tkahrs702-dotcom/hidden-device-hunter/firmware/phase3-p4-rfcam/README.md

# Phase 3 firmware: not written

This folder is a placeholder. See [`../../docs/manual/03-phase3-p4-rf-camera.md`](../../docs/manual/03-phase3-p4-rf-camera.md).
