tkahrs702-dotcom/hidden-device-hunter/docs/parts.md

# Parts and shopping

Prices checked online on **2026-10-03**; they move, so treat them as a guide. "Have" = Taelor already owns it.
The same list as a spreadsheet: [`parts.csv`](parts.csv).

## Totals

| Phase | New parts cost (USD) | Notes |
|---|---|---|
| 1 | about **$7–14**, plus $10–20 if you need a power bank | Uses the Uno R4 you have |
| 2 | about **$24–35** | Adds to Phase 1; nothing from Phase 1 is thrown away |
| 3 | don't buy yet | No firmware exists for Phase 3 (see `phase3.md`) |

## Phase 1 — buzzer finder

| Part | Qty | Pick | Where to buy (price) |
|---|---|---|---|
| Arduino Uno R4 WiFi | 1 | — | Have |
| Passive piezo buzzer | 1 | A **passive** 2-pin piezo (needs a signal to make sound), or a 3-pin passive buzzer module. Not "active". | [Keyestudio passive module ($3.80)](https://www.keyestudio.com/products/free-shipping-keyestudio-passive-buzzer-alarm-module-for-arduino) · [Aretronics passive module ($1.00)](https://aretronics.com/products/passive-buzzer-module) · any electronics store, 10-packs of 2-pin passive piezos run about $8–10 |
| 100 Ω resistor, 1/4 W | 1 | Brown-black-brown | Any resistor kit; skip it if you use a 3-pin module |
| Mini breadboard + jumper wires | 1 + 4 | 170- or 400-point breadboard, male-male jumpers | Any store; about $5–10 for both |
| USB-C cable | 1 | Must be a **data** cable (charge-only cables won't upload) | Have, most likely |
| USB power bank | 1 | Any 5V bank. Get a **2-port** one: Phase 2 needs both
