tkahrs702-dotcom/hidden-device-hunter/docs/worklog/2026-10-05-hal-setup.md

# 2026-10-05 HaL setup check
Asked from the Claude app Project: set up HaL for this project per `docs/computers.md` and run `tools/setup.sh`. Run on HaL (user `user1`).

- Checked out `claude/build-manual-schematics-4gaef6` (PR #2). `tools/setup.sh --check`: repo location ok, git up to date, then
  stopped: `arduino-cli not installed`. `~/.arduino15` does not exist, so no cores either.
- `user1` is not in `dialout` (groups: adm cdrom sudo dip plugdev users lpadmin sambashare kvm). Fix needs sudo:
  `sudo usermod -aG dialout user1`, then log out and back in.
- No serial boards plugged into HaL (no `/dev/ttyACM*`, `/dev/ttyUSB*`, `/dev/serial/by-id/`).
- Doc fix in `docs/computers.md`: the HaL column said "run `tools/setup.sh` once", but the script does not install arduino-cli.
  Added the no-sudo install command (pinned 1.3.1, into `~/.local/bin`) and a note on the esp32 core download size.
- Nothing installed, nothing flashed. Waiting on Taelor's yes for the arduino-cli install and core downloads.
- Taelor asked for HaL and HaLjr to be told what each still needs to do. HaLjr was unreachable from HaL (`haljr.local` did not resolve,
  no SSH answer on the LAN), so the per-computer to-do list went into `HANDOFF.md` (section "Computers") and a brief in
  claude-hub `readmes/briefs/`, which `claude-sync` shares to every computer.
- Taelor said yes. Installed arduino-cli 1.3.1 into `~/.local/bin`. First `tools/setup.sh` run failed downloading the ARM toolchain
  (`context deadline exceeded` at ~200 KB/s); after `arduino-cli config set network.connection_timeout 1800s` the rerun installed
  arduino:renesas_uno 1.6.0 and esp32:esp32 3.3.12, and compiled phase1-r4-finder, phase2-r4-display and phase2-xiao-sniffer (all ok).
  Remaining WARN: `user1` not in `dialout`. `arduino-cli board list`: no boards found. Added the timeout tip to `docs/computers.md`.
- Taelor ran `sudo usermod -aG dialout user1`; `/etc/group` confirms it. Login sessions started before that still lack the group, and
  `setup.sh` used to call that "not in dialout". It now checks the account too and says when only a log-out/log-in is pending.
