tkahrs702-dotcom/hidden-device-hunter/docs/worklog/2026-10-03-manual.md

# 2026-10-03: full manual written
- Taelor asked why the README was thin; the project held only the copied Android-app docs. Wrote `docs/manual/` (00-05): per-phase parts, pin-to-pin wiring, ASCII diagrams, assembly, software, test sketches, troubleshooting, verification log.
- Verified against sources: P4 40-pin header table (Waveshare), XIAO pin map (Seeed), R4 D0/D1/5 V logic/8 mA limit (Arduino docs). Not verified: R4 tone() on D8, P4 battery polarity, P4 5V on LiPo, Adafruit 757/BNO085 details (from the original guide).
- Firmware still not written. README rewritten as an index.
- Later same day: closed all open verification items. tone() works on any pin (core source); 757 silkscreen read from Adafruit board file; BNO085 alternate address 0x4B is via DI high, not ADR (manual corrected); P4 battery J2 pin1=BAT and header 5V = VCC_5V rail with battery boost, read from Waveshare schematic. Only two bench multimeter checks remain.
