tkahrs702-dotcom/hidden-device-hunter/docs/manual/05-reference.md

# 05. Pin reference, wire index and diagrams

## Diagram index (`docs/manual/diagrams/`)
| File | Shows |
|---|---|
| [`system-overview.svg`](diagrams/system-overview.svg) | every board, which phase adds it, the links between them and their voltage |
| [`phase1-wiring.svg`](diagrams/phase1-wiring.svg) / [`phase1-schematic.svg`](diagrams/phase1-schematic.svg) | R4 + resistor + buzzer |
| [`level-shifter.svg`](diagrams/level-shifter.svg) | generic vs Adafruit 757 pin names, one channel's circuit, channel use per phase |
| [`phase2-wiring.svg`](diagrams/phase2-wiring.svg) / [`phase2-schematic.svg`](diagrams/phase2-schematic.svg) | Historical XIAO-S3 layout; do not use for current Phase 2 wiring |
| [`phase2-xiao-c5-wiring.svg`](phase2-xiao-c5-wiring.svg) / [`phase2-xiao-c5-schematic.svg`](phase2-xiao-c5-schematic.svg) | Updated Seeed XIAO ESP32-C5 wiring, UART pin mapping and separate USB power |
| [`phase3-wiring.svg`](diagrams/phase3-wiring.svg) / [`phase3-schematic.svg`](diagrams/phase3-schematic.svg) | P4 + XIAO + BNO085 + camera + LiPo, optional R4 link |
The SVGs are generated by [`tools/diagrams/make_diagrams.py`](../../tools/diagrams/make_diagrams.py) (Python 3, no dependencies):
```
python3 tools/diagrams/make_diagrams.py          # rewrite all SVGs
tools/diagrams/render.sh /tmp/hdh-render         # optional: PNG previews (needs Chromium headless_shell)
```
Change a pin in the script, the phase file's wire list and the firmware together, never one alone.

## Wire colours (same in every diagram)
| Colour | Meaning |
|---|---|
| red | 5 V power or reference |
| orange | 3.3 V power or reference |
| black | ground |
| magenta | LiPo + |
| purple | Archived Phase 1 buzzer signal; do not use for V2 |
| yellow | R4 TX -> XIAO RX (Phase 2); parked Phase 3 I2C SCL |
| green | XIAO TX -> R4 or P4 RX |
| cyan | P4 TX -> XIAO RX |
| brown | P4 TX -> R4 RX (optional) |
| blue | I2C SDA |
| grey | coax / USB cable |
Dashed = optional. Real jumper colours do not matter; the IDs do.

## V2 Phase 2 wires, by ID
| ID | Phase | From | To | Jumper |
|---|---|---|---|---|
| P1 | 2 | R4 5V | shifter HV only | - |
| P2 | 2 | XIAO 3V3 | shifter LV | - |
| P3 | 2 | R4 GND | shifter high-side GND | - |
| P4 | 2 | XIAO GND | shifter low-side GND | - |
| S1 | 2 | R4 D1 (TX) | shifter B1/A1 | - |
| S2 | 2 | shifter A1/B1 | XIAO D7 (RX, GPIO12) | - |
| S3 | 2 | XIAO D6 (TX, GPIO11) | shifter A2/B2 | - |
| S4 | 2 | shifter B2/A2 | R4 D0 (RX) | - |
| A1 | 2 | XIAO C5 RF connector | Rokland antenna cable (check connector when delivered) | - |
R4 and XIAO are powered separately over USB-C for Phase 2 bench tests; their 5 V rails are not connected.
Phase 1 uses the Qwiic Modulino Buzzer and requires no jumper-wire table. The older D8 passive-buzzer wiring is archived in `01-phase1-finder.md`; it is not current V2 hardware. Phase 3 connections below are preserved design notes only and are not V2 build instructions.

## Signals between boards
| Link | Signal | Level | Direction | Wires |
|---|---|---|---|---|
| XIAO -> R4 (Phase 2) | UART 115200 8N1 | 3.3 V XIAO / 5 V R4 via shifter | XIAO -> R4; reverse direction reserved | XIAO D6/GPIO11 -> A2/B2 -> R4 D0; R4 D1 -> B1/A1 -> XIAO D7/GPIO12 reserved; common GND |
| XIAO <-> P4 (Phase 3) | UART 115200 8N1 | 3.3 V | both | T3 (XIAO D6 -> P4 pin 11 GPIO5); T4 (P4 pin 14 GPIO4 -> XIAO D7); ground T2 |
| P4 -> R4 (optional) | UART | 3.3 V to 5 V via shifter ch 3 | one way | O1, O4 (P4 pin 8 GPIO2 -> LV3/HV3 -> R4 D0) |
| BNO085 <-> P4 | I2C 0x4A | 3.3 V | both | I2 SDA pin 4, I3 SCL pin 6 |
| R4 -> buzzer | tone, about 2.5 kHz | 5 V | out | W1 D8 via R1 100 ohm |

XIAO -> R4 line protocol (`phase2-xiao-sniffer` -> `phase2-r4-display`), one ASCII line each, `\n` terminated:
| Line | Meaning | Rate |
|---|---|---|
| `L,<MAC>,<cat>,<maker>` | locked onto MAC; cat 0 unknown, 1 camera maker, 2 IoT chip | on lock |
| `U` | unlocked | on unlock and at boot without a saved lock |
| `T,<now>,<avg>,<ch>,<pps>,<idle pps>,<wobble dB>,<wave 0/1>` | target RSSI now and averaged (dBm), channel, packets/s, idle packets/s, wobble (dB spread), hand-wave spike flag | up to 10 per second while heard |
| `S,<total>,<cams>,<iot>,<hidden>,<locked>` | devices heard in the last 60 s | once a second |

## Power
| Board | Powered from | Notes |
|---|---|---|
| R4 | USB-C (computer or power bank) | 5 V pin ~4.7 V on USB; max 8 mA per I/O pin, 60 mA total |
| XIAO (Phase 2 bench) | its own USB-C | Separate from R4 USB-C; do not connect the 5 V rails |
| XIAO (Phase 3) | P4 header pin 1 (5V) via T1 | never also plug its USB-C; Seeed's "5V dead on battery" refers to the XIAO's own battery pads, not this feed; P4 header 5V comes from its boost on LiPo |
| Shifter | HV from R4 5V, LV from XIAO 3V3 (Phase 2) or P4 pin 18 (Phase 3) | both sides must be powered for data to pass |
| BNO085 | P4 pin 2 (3V3) | |
| P4 | USB-C or MX1.25 LiPo | short-press POWER |

## Board pin cheats
- **R4 (USB-C on the left):** top header SCL SDA AREF GND 13 12 11 10 9 8 | 7 6 5 4 3 2 TX>1 RX<0. Bottom header (blank) IOREF RESET 3.3V 5V GND GND VIN | A0-A5.
  D0 = RX, D1 = TX (`Serial1`). Debug on USB `Serial`. 12x8 LED matrix on board.
- **Seeed XIAO ESP32-C5:** D6=GPIO11/TX, D7=GPIO12/RX, BOOT=GPIO28.
- **XIAO ESP32-S3 (legacy pin reference only):** left column D0-D6, right column 5V, GND, 3V3, D10, D9, D8, D7.
  D0=GPIO1, D1=2, D2=3, D3=4, D4=5 (SDA), D5=6 (SCL), D6=43 (TX), D7=44 (RX), D8=7, D9=8, D10=9. BOOT button = GPIO0.
- **Shifter:** see [`level-shifter.svg`](diagrams/level-shifter.svg) and 02 section 2.2.
- **P4 header:** see the full table in [`03-phase3-p4-rf-camera.md`](03-phase3-p4-rf-camera.md).

## Verification status
All items from the original guide are checked against sources (see the log in `00-overview-and-safety.md`).
Two bench confirmations remain, both one-minute multimeter checks done when you have the hardware:
1. Header 5V (pin 1 or 3) reads about 5 V when the P4 runs on LiPo alone (the schematic says yes).
2. LiPo plug: red wire lands on J2 pin 1 (BAT) and black on pin 2 (GND) before you connect it.
Diagrams are drawn from the same sources; physical part positions (R4 matrix, XIAO u.FL socket, P4 connectors) are approximate, pin
order is exact. Generic shifter clones vary in pin order: wire by the printed label.
