tkahrs702-dotcom/hidden-device-hunter/docs/worklog/2026-10-26-c5-firmware-review.md

# 2026-10-26: C5 sniffer and R4 display review

- Reviewed `phase2-xiao-sniffer` and `phase2-r4-display`. Pins (D6=GPIO11, D7=GPIO12, BOOT=GPIO28) are not the C5's USB pins (GPIO13/14), so the firmware cannot switch USB off. The default Tuya lock (10:5A:17:6C:02:4D, ver 1) is applied on the first boot; the R4's X confirms it was.
- Fixed: a locked target that went quiet for 4 s sent the C5 back to sweeping all 36 channels (8+ s per pass), so a plug that talks every few seconds was almost never caught and the R4 sat on X. The C5 now waits on the target's last channel for 30 s before sweeping.
- Fixed: USB text could stall the loop up to 100 ms per line when a computer was attached but nothing read the port; it is now dropped instead.
- Flash failures ("Failed to start stub flasher", "No serial data received") come from the USB reset into download mode, not the sketch. Hold BOOT while plugging the C5 in, then upload.
- Not run on hardware in this session; CI compiles it.
- PRs #9 and #10 merged. Added a peak marker on the R4: a dot on the top row over the best bar reached since the lock, so the closest approach can be read after walking away. Resets on a new lock.
- Phone dashboard (JS syntax-checked, C++ compiled by CI only, not run on hardware): the R4 makes Wi-Fi "HDH-Finder" and serves http://192.168.4.1 with the monitored target, live dBm, closest approach, graph, warmer/colder recommendation, sniffer counts and the 6 nearby suspects, plus an "All devices" list of up to 60 with maker and network name (`webview.h`; the C5 now sends B/D lines every 2 s).
- Hidden networks: the phone lists now rank camera makers, IoT chips, then hidden networks (labelled "hidden net") before everything else, in the same order as the C5's BOOT button, and a BOOT column says how many presses lock each suspect. Hold BOOT 1 s resets the count. Hidden devices that only probe use random MACs and cannot be locked by MAC.
- 2026-10-27: phone dashboard moved to Bluetooth LE on the C5 (decision: C5 Bluetooth, Android). The C5 streams the same lines it sends the R4 (plus a 40-device list with packets, last-heard and flags) to a connected phone and accepts `K,<MAC>` (track), `U` (unlock) and `V,<0-3>` (buzzer volume, forwarded to the R4 over the existing one-way wire). The page is `tools/finder/finder.html` (Web Bluetooth, Chrome on Android). The page was tested in demo mode in a headless browser; the Bluetooth link itself is untested on hardware.

## 2026-10-27
Added the C5 Bluetooth LE scan and a Wi-Fi / Bluetooth / both switch (default Wi-Fi only), a mode switch on `tools/finder/finder.html`, and a handoff doc. Hardware tests were frustrating (flash timing, R4 Wi-Fi flaky, Brave blocks Web Bluetooth, private repo links). Taelor asked for a note that the approach needs rethinking for ease of use: `docs/v2/NOTE-ease-of-use-redesign.md`.
