tkahrs702-dotcom/hidden-device-hunter/docs/worklog/2026-10-17-modulino-buzzer-status.md

# 2026-10-17: Modulino buzzer flashed (status note)
Status recorded in the Photo to Sold Claude project (thread "Flash R4 network finder") and first sent to the sentinel session by mistake; filed here where it belongs.
- Hardware: Arduino UNO R4 WiFi with a Modulino Buzzer on the Qwiic socket, plugged into HaLjr (not HaL).
- Phase 1: `firmware/phase1-r4-finder/phase1-r4-finder.ino`. The Modulino version was written on HaLjr around 9:17 that morning and not committed. Flashed 17:16 UTC: boot printed "Buzzer found", the beep test worked, and the scan listed CenturyLink8864 at about -65 dBm. Pushed to branch `modulino-buzzer` (not merged to main).
- Phase 2 Modulino sketch compiles but is not flashed; it needs the XIAO wired first.
- Wiring reference: Taelor's "Hidden Device Hunter Wiring" page (updated 2026-10-17). Three older docs from the Android app could not be opened.
- Serial Monitor: 115200 baud, Newline line ending. Typing a network's number locks onto it.
- Working preference: once Taelor says "drive it" or "just do it", deliver the end result with no questions or check-ins; stop only for something that needs their hands, stated in one line.
