tkahrs702-dotcom/hidden-device-hunter/docs/worklog/2026-10-04-firmware-import.md

# 2026-10-04 firmware import
A claude.ai cloud session (2026-10-03) couldn't create the GitHub repo, so it left a git bundle in `readmes/inbox/`.
The repo already existed here (docs moved from sentinel), so the bundle's firmware/ and tools/ were copied in rather than
merging histories. Its README/HANDOFF/CLAUDE.md were dropped (this repo's docs are newer and fuller). Not run on hardware yet.
