tkahrs702-dotcom/hidden-device-hunter/docs/worklog/2026-10-03-split-from-sentinel.md

# 2026-10-03: Hidden Device Hunter made its own project
- Docs from the Claude Android app were first filed inside sentinel as `docs/rf-finder/`. Taelor intended a separate project; moved here.
- Files: README, HANDOFF (root), build-plan and setup-guide (`docs/`). Earlier filing history is in the sentinel worklog `2026-10-03-rf-finder-docs.md`.
- Status unchanged: planning only, nothing built or bought.
