tkahrs702-dotcom/hidden-device-hunter/(commit log)

2026-10-04 Hidden Device Hunter: docs moved from sentinel
2026-10-04 Manual: close open verification items from schematic and source files
2026-10-05 Manual: SVG schematics and pin-to-pin wiring diagrams, step-by-step build guide
    Adds 8 generated SVG diagrams (system overview, level shifter, wiring and
    schematic for Phases 1-3) and rewrites the Phase 1 and 2 chapters as a
    step-by-step build: wire IDs, jumper types, meter checks before and after
    power, flashing, use and troubleshooting. Pins match the sketches.
    Claude-Session: https://claude.ai/code/session_01Y2WwFBATjkympu3mmpoX7w
2026-10-05 computers.md: HaL needs arduino-cli installed before setup.sh; worklog for HaL setup check
2026-10-17 Use Modulino Buzzer on Qwiic instead of piezo on D8
    Phase 1 and 2 beeper now drives a Modulino Buzzer over Wire1 from a
    FreeRTOS task so beeps keep rhythm during WiFi scans. Adds t = test
    buzzer command and a diag-modulino I2C check sketch. Flashed and
    verified on the UNO R4 WiFi (buzzer found, scan list prints).
    [beeper.h, diag-modulino.ino, phase1-r4-finder.ino, phase2-r4-display.ino]
2026-10-17 Add diag-wifiscan-esp32 for side-by-side scan with a TTGO
    Claude-Session: https://claude.ai/code/session_01Kt6CqQox7BUz1wWvjiqXcd
2026-10-18 Finder: AUTO mode follows the strongest network when none is locked
    No computer needed to pick a target; beeps and bars track the nearest router or hotspot.
    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
2026-10-18 Design: handheld input and pointing (TTGO finder recommended)
    Written by the kumi:kai design agent; hardware facts checked against SENTINEL pin notes and 2026-10-17 measurements.
    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
2026-10-18 Phase 2 sniffer: build for the XIAO ESP32-C5 (2.4 + 5 GHz)
    BOOT pin per chip, US country code, dual-band hop list on chips with
    5 GHz, refused channels skipped. Manual, HANDOFF and worklog updated.
    Compiles for XIAO_ESP32C5 and XIAO_ESP32C3 on esp32 3.3.12; not run on
    hardware yet.
    Claude-Session: https://claude.ai/code/session_01JV3FEm1eaRHcQft7RRYqNd
    [phase2-xiao-sniffer.ino]
2026-10-19 Sniffer: skip only refused channels, check 5 GHz band mode directly
    Review follow-up: a temporary esp_wifi_set_channel failure no longer
    marks a channel bad forever, and the 5 GHz warning no longer fires
    falsely (WiFi.setBandMode checks STA.started(), set later by an event).
    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
    [phase2-xiao-sniffer.ino]
2026-10-23 WIP 2026-10-19: stage 1/2 audit fixes, XIAO C5 sniffer, V2 docs (committed as-is)
    [phase1-r4-finder.ino, phase2-r4-display.ino, phase2-xiao-sniffer.ino]
2026-10-25 Remove the Gmail printout PDF (personal email in a public repo)
    Claude-Session: https://claude.ai/code/session_019esvRcVXs6BgWem9NCdiGN
2026-10-25 Rules: keep one pointer to claude-hub instead of a copy (Taelor approved)
    The copied rules went out of date and collided with the current ones.
    Claude-Session: https://claude.ai/code/session_01VNAwrb8rpvDJmAgEYSSpgh
2026-10-26 Fold HANDOFF into README; keep the project separate from SENTINEL
    Current state now lives in the README Where we left off. Old HANDOFF archived on HaLjr; its reference parts are in docs/reference.md. Taelor 2026-10-26: no SENTINEL boards, code, docs or tools.
2026-10-26 Sniffer: accept a bare CR as Enter on the USB command line
    arduino-cli monitor sends \r for Enter, and the sniffer ignored \r and waited
    for \n, so typed commands (l, u, numbers) never ran.
    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
2026-10-26 Phase 2: make the sniffer link visible without a computer
    - R4 display: a steady top-right dot shows the sniffer's status lines are
    arriving, and the lock state in each status line resyncs a lock or unlock
    whose L/U line was missed (e.g. the sniffer booted before the R4).
    - C5 sniffer: blink the user LED (slow = scanning, fast = target heard,
    medium = target lost) so the board shows it is running.
    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
    [meter.h, phase2-r4-display.ino, phase2-xiao-sniffer.ino]
2026-10-26 Sniffer: lock a default target on the first boot after flashing
    DEFAULT_LOCK (Taelor's Tuya device) is locked once per DEFAULT_LOCK_VER,
    so the handheld finds it with no serial typing; B and u still change the
    lock afterwards.
    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
2026-10-26 Sniffer: wait on a quiet target's channel, never stall on USB text
    Claude-Session: https://claude.ai/code/session_01YKZUS1CoBH2CQb2nPSvVra
    [phase2-xiao-sniffer.ino]
2026-10-26 Phone page: complete device list with maker and network name
    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
2026-10-26 Phone page: list up to 60 devices
    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
2026-10-26 R4: build the phone JSON in small pieces so it fits in RAM
    The 60-device list pushed the R4 sketch over its RAM limit.
    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
2026-10-26 R4: shrink the device list so the phone page fits in RAM
    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
2026-10-27 R4: keep reading the sniffer link while the phone page is being sent
    The slow Wi-Fi writes let the serial buffer overflow, so the page saw no data.
    The C5 also sends the device list every 4 s instead of 2 s.
    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
2026-10-27 Plan volume control and per-device check
    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
2026-10-27 Sniffer: swap the link pins in code to match the crossed wiring
    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
    [phase2-xiao-sniffer.ino]
2026-10-27 C5: Bluetooth LE phone link (track, unlock, volume); R4: buzzer volume levels
    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
    [beeper.h, phase2-r4-display.ino, phase2-xiao-sniffer.ino]
2026-10-27 Plan: Bluetooth device finding on the C5
    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
2026-10-27 Add handoff doc for the Bluetooth scan, mode switch and phone dashboard
    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
2026-10-27 C5 Bluetooth LE scan and Wi-Fi/Bluetooth/both mode switch; page switch
    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
2026-10-27 Note: current setup is too fiddly, rethink for ease of use
    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
2026-10-27 Finder page: Scan-for buttons work in demo, Connect stops the demo
    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
2026-10-27 R4 page: Scan for buttons and BLE channel label; C5 reads mode commands from the R4
    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
2026-10-28 R4 page: fix slow and dropping phone connection (#17)
    * R4 page: poll one request at a time and 404 stray requests to fix slow, dropping connections
    * Plan: Phase 3 painless phone access
    * Finder page: auto-reconnect, remembered finder, screen stays on
    * C5: clear the queued phone lines when a phone con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
    [phase2-r4-display.ino, phase2-xiao-sniffer.ino, webview.h]
2026-10-30 Telemetry: hand-wave spike, packets/s and signal wobble on the locked target
    The C5 adds packets/s, its idle baseline, the wobble (dB spread of recent readings)
    and a wave-spike flag to each T line. The R4 page and the phone Bluetooth page show
    them; older T lines without the extra fields still work.
    Claude-Session: https://claude.ai/code/session_01VtBEMudkDho2HnV8o5uLVM
    [phase2-r4-display.ino, phase2-xiao-sniffer.ino, webview.h]
2026-10-30 Telemetry: fix reviewer findings (wave flag latching, 0 pkt/s shown when not measurable, log keeps newest lines)
    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
    [phase2-xiao-sniffer.ino]
2026-10-30 Telemetry: hand-wave spike, packets/s, signal wobble and phone Save log (#18)
    * Finder page: session log of every reading, saved as a CSV file
    * Telemetry: hand-wave spike, packets/s and signal wobble on the locked target
    Claude-Session: https://claude.ai/code/session_01VtBEMudkDho2HnV8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
    [phase2-r4-display.ino, phase2-xiao-sniffer.ino, webview.h]
2026-10-30 One-command flash script and a printable QR code that opens the Bluetooth finder page
    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
2026-10-30 Flash script and steps: fix reviewer findings (first-run pull, pull failure stops, stash notice, argument check, print path, internet note)
    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
2026-10-30 C5 Bluetooth low profile: plain name, advertise only 2 min after power-on, disconnect or BOOT press; page finds it by service
    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
2026-10-30 C5 Bluetooth: fix declaration order (compile), 10 min to rejoin after a dropped link, page hints BOOT
    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
    [phase2-xiao-sniffer.ino]
2026-10-30 Roadmap: find devices that attack home devices (detect, point, robust, later)
    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
2026-10-30 Attack roadmap: learn the watch-list automatically; note on the TTGO boards
    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
